labdvm/Phenix-1255-HW/documentation/images/FRDM-MCXN947.jpg

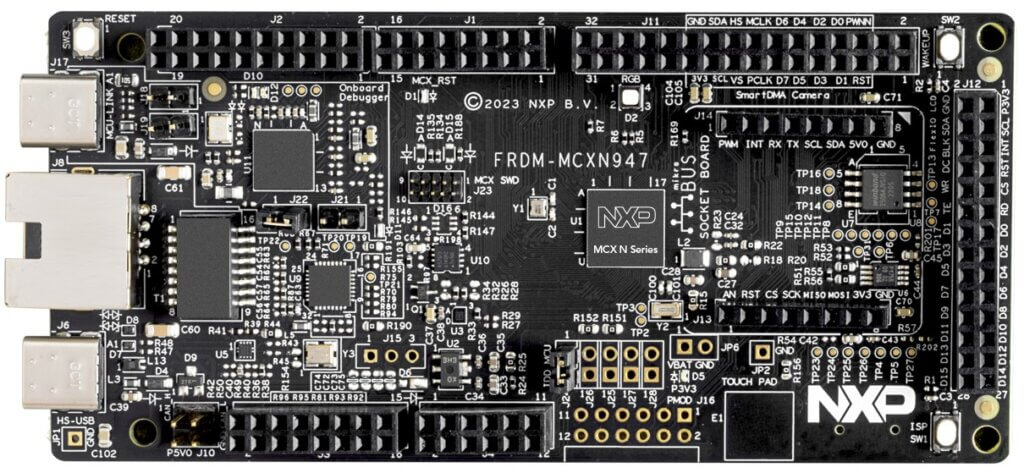
documentation/images/FRDM-MCXN947.jpg
