labdvm/Phenix-1255-HW/FRDM-SX1255+/FRDM-SX1255+ V2_b.png

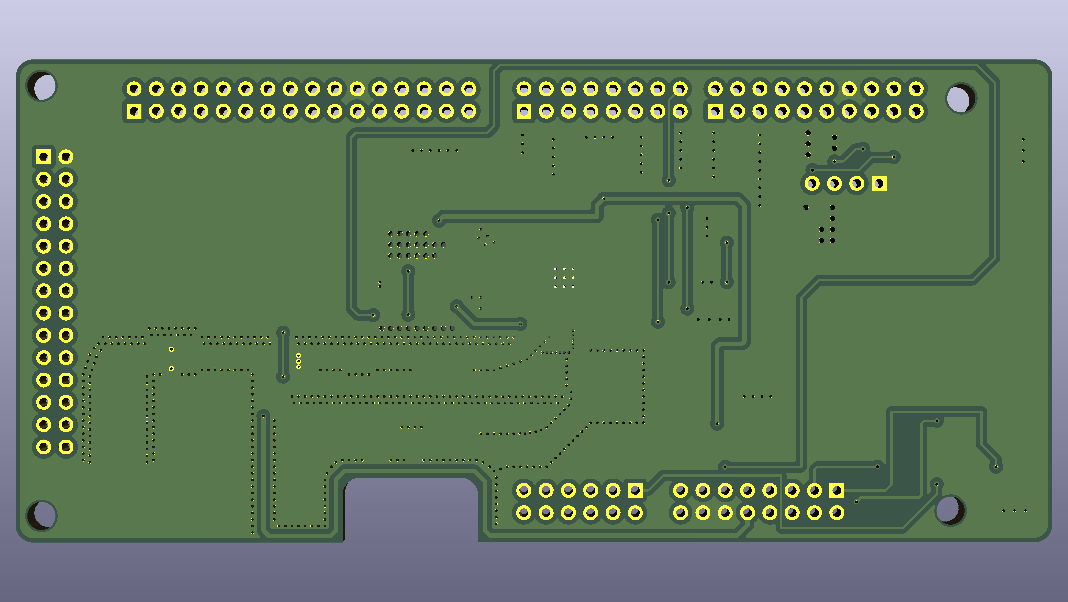
FRDM-SX1255+/FRDM-SX1255+ V2_b.png
