labdvm/Phenix-1255-HW/FRDM-SX1255/FRDM-SX1255-V2.png

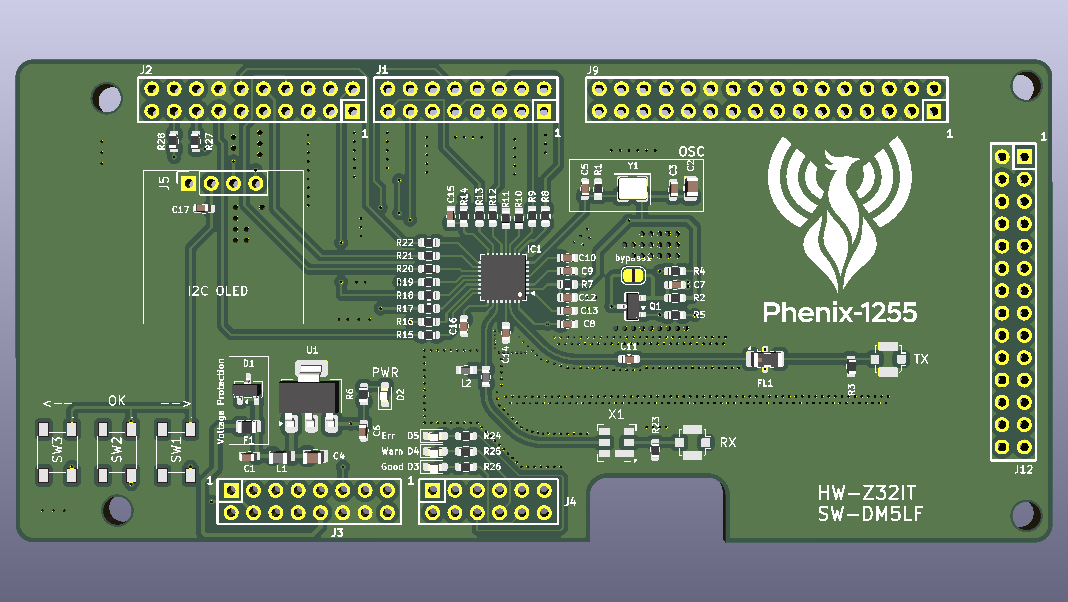
FRDM-SX1255/FRDM-SX1255-V2.png
