labdvm/Phenix-1255-HW/FRDM-SX1255+/Gerber and BOM/FRDM-SX1255+ V2.kicad_pcb_bom.csv

Designator | Quantity | Value | Footprint | Package | MPN | DNP | Mount_Type | KiLib_Generator | Manufacturer | Manufacturer Product Number | Description | DigiKey Part Number | Sim.Pin | TCXO-Footprints
C1, C12, C15, C18, C6, C7 | 6 | 1u | C_0603_1608Metric |  | 311-3484-1-ND |  | smt | SMD_2terminal_chip_molded | YAGEO | CC0603JRX7R6BB105
C10, C16, C17, C3, C8, C9 | 6 | 100n | C_0603_1608Metric |  | 720-1688-1-ND |  | smt | SMD_2terminal_chip_molded | Vishay Vitramon | VJ0603Y104JXQPW1BC
C11, C14, C19, C20 | 4 | 100p | C_0603_1608Metric |  | 399-15348-1-ND |  | smt | SMD_2terminal_chip_molded | KEMET | C0603C101J8GACTU
C13 | 1 | 10n | C_0603_1608Metric |  | 399-C0603C103K8RACTUCT-ND |  | smt | SMD_2terminal_chip_molded | KEMET | C0603C103K8RACTU
C2, C4 | 2 | 22u | C_0805_2012Metric |  | 1276-6526-1-ND |  | smt | SMD_2terminal_chip_molded | Samsung Electro-Mechanics | CL21A226KOQNNNE
C5 | 1 | 10p | C_0603_1608Metric |  | 399-14932-1-ND |  | smt | SMD_2terminal_chip_molded | KEMET | C0603C100J8GACTU
D1 | 1 | SP0502BAHT | SOT-23-3 |  |  |  | smt | package/gullwing | Littelfuse Inc. | SP0502BAHTG | TVS Diode Array, 5.5V Standoff, 2 Channels, SOT-23 package | F2714CT-ND
D2 | 1 | PWR | LED_0603_1608Metric_Pad1.05x0.95mm_HandSolder |  | 160-LTST-T180UWETCT-ND |  | smt | SMD_2terminal_chip_molded | Lite-On Inc. | LTST-T180UWET | Light emitting diode, small symbol |  | 1=K 2=A
D3 | 1 | Good | LED_0603_1608Metric_Pad1.05x0.95mm_HandSolder |  | 754-APT1608SGD3CT-ND |  | smt | SMD_2terminal_chip_molded | Kingbright | APT1608SGD3 | Light emitting diode, small symbol |  | 1=K 2=A
D4 | 1 | Warn | LED_0603_1608Metric_Pad1.05x0.95mm_HandSolder |  | 160-1437-1-ND |  | smt | SMD_2terminal_chip_molded | Lite-On Inc. | LTST-C190KSKT | Light emitting diode, small symbol |  | 1=K 2=A
D5 | 1 | Err | LED_0603_1608Metric_Pad1.05x0.95mm_HandSolder |  | 160-1479-1-ND |  | smt | SMD_2terminal_chip_molded | Lite-On Inc. | LTST-S270KRKT | Light emitting diode, small symbol |  | 1=K 2=A
F1 | 1 | 500mA | Fuse_0805_2012Metric |  |  |  | smt | SMD_2terminal_chip_molded | Littelfuse Inc. | 0805L050WR | Resettable fuse, polymeric positive temperature coefficient, small symbol | F2772CT-ND
FL1 | 1 | LFCN-490 | Filter_Mini-Circuits_FV1206 |  | 3157-LFCN-490+CT-ND |  | smt |  | Mini-Circuits | LFCN-490+
H1, H2, H3, H4 | 4 | Mechanical_MountingHole | MOUNTINGHOLE_3.2MM_M3 |  |  |  | tht
IC1 | 1 | SX1255 | QFN-32-1EP_5x5mm_P0.5mm_EP3.3x3.3mm_ThermalVias |  | SX1255IWLTRTCT-ND |  | smt | package/no_lead | Semtech Corporation | SX1255IWLTRT
J1 | 1 | TX | U.FL_Molex_MCRF_73412-0110_Vertical |  | 343-CONMHF1-SMD-G-TCT-ND |  | smt |  | TE Connectivity Linx | CONMHF1-SMD-G-T
J2 | 1 | RX | U.FL_Molex_MCRF_73412-0110_Vertical |  | 343-CONMHF1-SMD-G-TCT-ND |  | smt |  | TE Connectivity Linx | CONMHF1-SMD-G-T
L1 | 1 | 600 ohm/100MHz | L_0805_2012Metric |  | 490-1046-1-ND |  | smt | SMD_2terminal_chip_molded | Murata Electronics | BLM21BD601SN1D | FERRITE BEAD 600 OHM 0805 1LN
L2 | 1 | 82n | L_0603_1608Metric |  | 490-LQW18AS82NG00DCT-ND |  | smt | SMD_2terminal_chip_molded | Murata Electronics | LQW18AS82NG00D
L3 | 1 | 39n | L_0603_1608Metric |  | 490-LQW18AS39NG00DCT-ND |  | smt | SMD_2terminal_chip_molded | Murata Electronics | LQW18AS39NG00D
L4 | 1 | 68nH | L_0603_1608Metric |  | 490-1178-1-ND |  | smt | SMD_2terminal_chip_molded | Murata Electronics | LQW18AN68NJ00D
Q1 | 1 | BSS84 | SOT-23 |  | BSS84-TPMSCT-ND |  | smt | package/gullwing | MCC (Micro Commercial Components) | BSS84-TP
R1, R32, R4 | 3 | 10K | R_0603_1608Metric |  | 541-10.0KHCT-ND |  | smt | SMD_2terminal_chip_molded | Vishay Dale | CRCW060310K0FKEA
R10, R11, R12, R19, R20, R22, R5 | 7 | 330R | R_0603_1608Metric |  | 541-330HCT-ND |  | smt | SMD_2terminal_chip_molded | Vishay Dale | CRCW0603330RFKEA
R13, R15, R16, R17, R18, R21, R27, R28, R8, R9 | 10 | 33R | R_0603_1608Metric |  | 541-33.0HCT-ND |  | smt | SMD_2terminal_chip_molded | Vishay Dale | CRCW060333R0FKEA
R14, R2, R34, R7 | 4 | 1R | R_0603_1608Metric |  | 541-1.00HHCT-ND |  | smt | SMD_2terminal_chip_molded | Vishay Dale | CRCW06031R00FKEA
R23, R3 | 2 | 1M | R_0603_1608Metric |  | 541-1.00MHCT-ND |  | smt | SMD_2terminal_chip_molded | Vishay Dale | CRCW06031M00FKEA
R24, R25, R26 | 3 | 1K5 | R_0603_1608Metric |  | 541-1.5KGCT-ND |  | smt | SMD_2terminal_chip_molded | Vishay Dale | CRCW06031K50JNEA
R29, R31 | 2 | 150R | R_0603_1608Metric |  | YAG1533CT-ND |  | smt | SMD_2terminal_chip_molded | YAGEO | RT0603BRD07150RL
R30 | 1 | 36R | R_0603_1608Metric |  | 13-RT0603BRC0736RLCT-ND |  | smt | SMD_2terminal_chip_molded | YAGEO | RT0603BRC0736RL
R33 | 1 | 33K | R_0603_1608Metric |  | 541-33.0KHCT-ND |  | smt | SMD_2terminal_chip_molded | Vishay Dale | CRCW060333K0FKEA
R6 | 1 | 3K3 | R_0603_1608Metric |  | 541-3.30KHCT-ND |  | smt | SMD_2terminal_chip_molded | Vishay Dale | CRCW06033K30FKEA
SW1 | 1 | --> | PTS647SK38SMTR2LFS |  |  |  | smt |  | E-Switch | TL3305CF260QG | Push button switch, generic, two pins | EG5355CT-ND
SW2 | 1 | OK | PTS647SK38SMTR2LFS |  |  |  | smt |  | E-Switch | TL3305CF260QG | Push button switch, generic, two pins | EG5355CT-ND
SW3 | 1 | <-- | PTS647SK38SMTR2LFS |  |  |  | smt |  | E-Switch | TL3305CF260QG | Push button switch, generic, two pins | EG5355CT-ND
U1 | 1 | MCP1703Ax-330xxDB | SOT-223-3_TabPin2 |  | MCP1703T-3302E/DBCT-ND |  | smt |  | Microchip Technology | MCP1703T-3302E/DB
U2 | 1 | TQP3M9036 | SON50P200X200X95-9N |  | 2312-TQP3M9036CT-ND |  | smt |  | Qorvo | TQP3M9036
Y1 | 1 | 38.4MHz | Crystal_SMD_3225-4Pin_3.2x2.5mm |  | 114-TG2520SMN38.4000M-MCGNNM3CT-ND |  | smt | crystal_resonator_oscillator | EPSON | TG2520SMN 38.4000M-MCGNNM3 | Clipped SW/0.5~1ppm |  |  | 3225 or 2510
