labdvm/Phenix-1255-HW/FRDM-SX1255+/3dmodels/TA0655A.stp

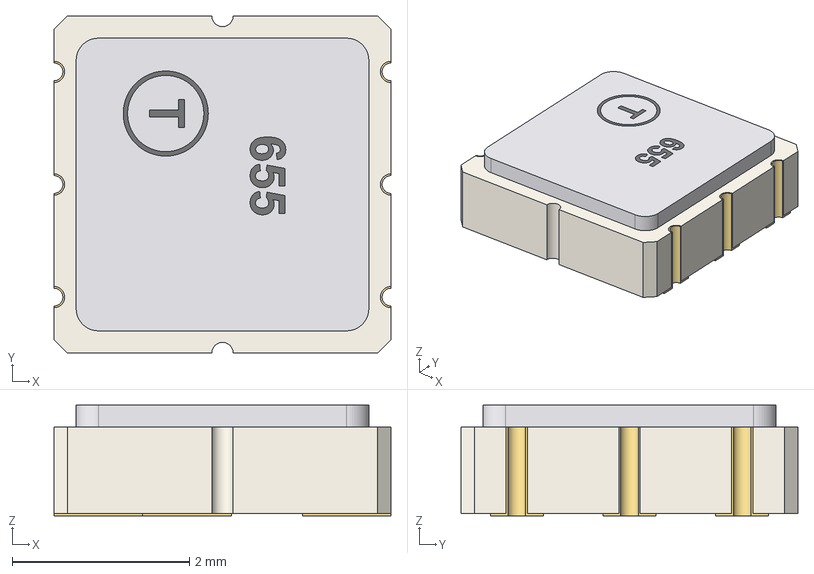
[picture p12: CAD file, 2026-11-04]
FRDM-SX1255+/3dmodels/TA0655A.stp
3.80 x 3.80 x 1.25 mm
lid
terminals
marking
