labdvm/Phenix-1255-HW/FRDM-SX1255/3dmodels/OLED_0.96in_128x64_I2C.stp

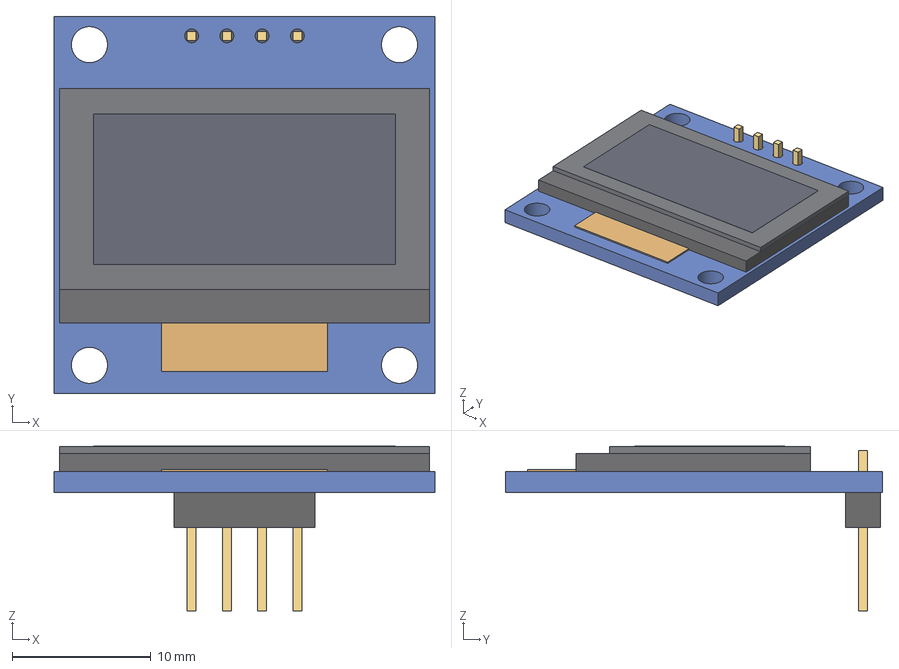
[picture p13: CAD file, 2026-11-04]
FRDM-SX1255/3dmodels/OLED_0.96in_128x64_I2C.stp
27.4 x 27.2 x 11.9 mm
pcb
glass
cover_glass
active_area
flex
header_body
header_pins
