labdvm/Phenix-1255-HW/FRDM-SX1255+/FRDM-SX1255+ V2.pdf

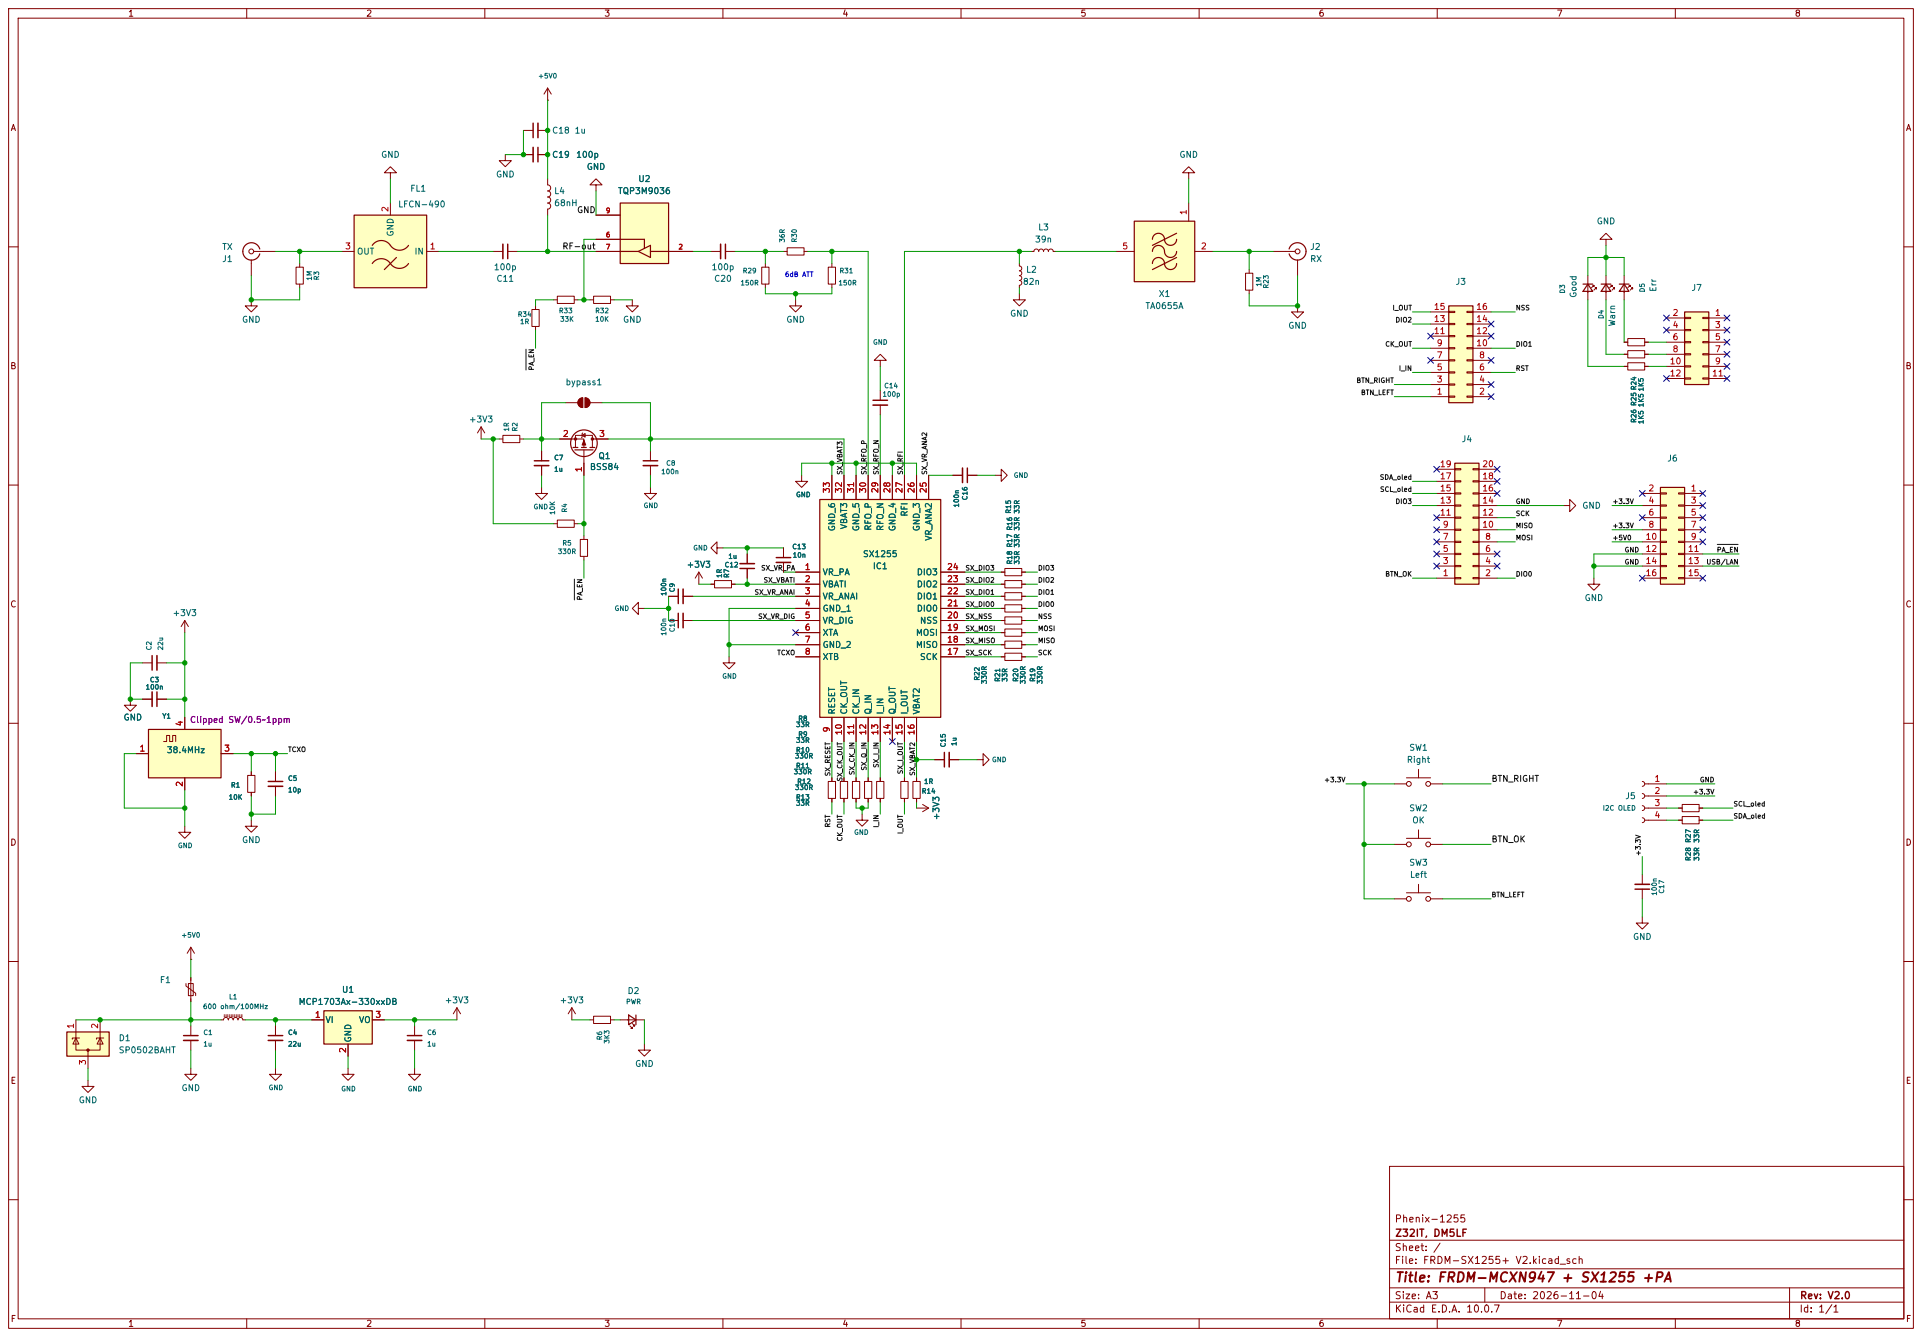
[picture p14: page 1]

Size: A3 | Rev: V2.0 | F Date: 2026-11-04
KiCad E.D.A. 10.0.7 | Id: 1/1
