labdvm/Phenix-1255-HW/FRDM-SX1255/FRDM-SX1255-V2.kicad_pcb

## KiCad design FRDM-SX1255/FRDM-SX1255-V2.kicad_pcb (2026-11-04)

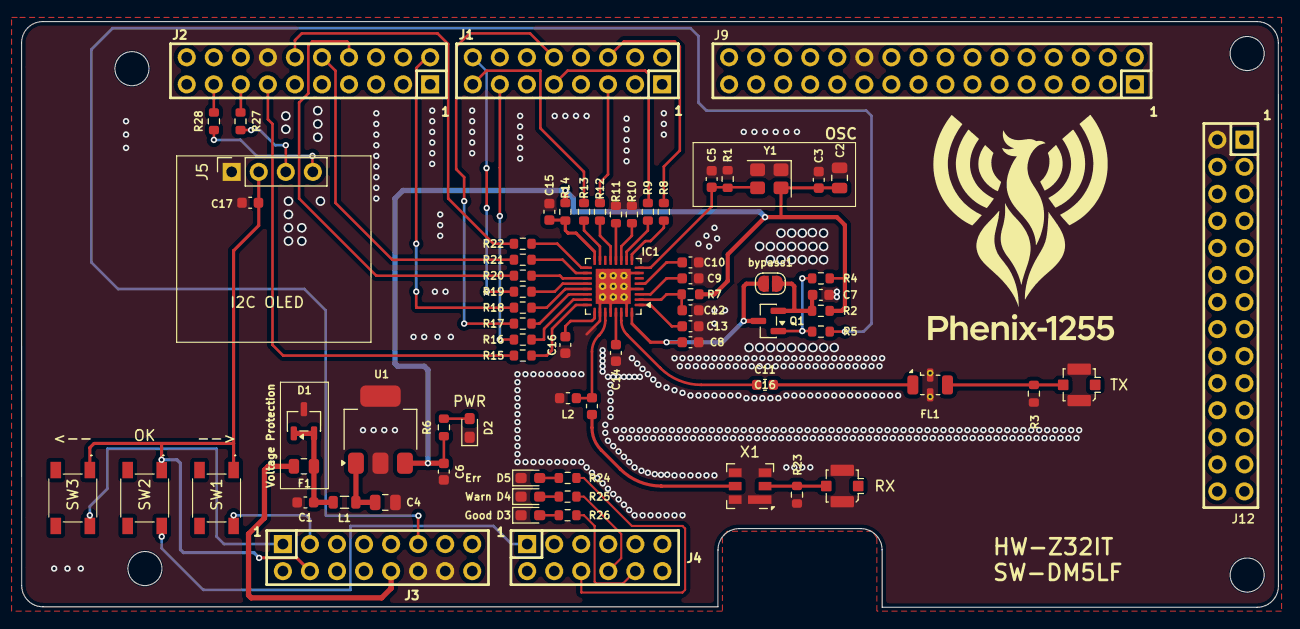
[picture p16: board FRDM-SX1255-V2.kicad_pcb from above]

Board: 2 copper layers, 118.0 x 55.0 mm, 77 parts (0 on the bottom side), 61 nets.

Parts:
C1, C6, C7, C12, C15: 1u; C_0603_1608Metric
C2, C4: 22u; C_0805_2012Metric
C3, C8, C9, C10, C16, C17: 100n; C_0603_1608Metric
C5: 10p; C_0603_1608Metric
C11, C14: 100p; C_0603_1608Metric
C13: 10n; C_0603_1608Metric
D1: SP0502BAHT; SOT-23-3
D2: PWR; LED_0603_1608Metric_Pad1.05x0.95mm_HandSolder
D3: Good; LED_0603_1608Metric_Pad1.05x0.95mm_HandSolder
D4: Warn; LED_0603_1608Metric_Pad1.05x0.95mm_HandSolder
D5: Err; LED_0603_1608Metric_Pad1.05x0.95mm_HandSolder
F1: 500mA; Fuse_0805_2012Metric
FL1: LFCN-490; Filter_Mini-Circuits_FV1206
H1, H2, H3, H4: Mechanical_MountingHole; MOUNTINGHOLE_3.2MM_M3
IC1: SX1255; QFN-32-1EP_5x5mm_P0.5mm_EP3.3x3.3mm_ThermalVias
J1, J3: SSQ-108-03-T-D
J1#2: TX; U.FL_Molex_MCRF_73412-0110_Vertical
J2: RX; U.FL_Molex_MCRF_73412-0110_Vertical
J2#2: SSQ-110-03-T-D
J4: SSQ-106-03-T-D
J5: I2C OLED; PinSocket_1x04_P2.54mm_Vertical
J9: SSQ-116-03-T-D
J12: SSQ-114-03-T-D
L1: 600 ohm/100MHz; L_0805_2012Metric
L2: 82n; L_0603_1608Metric
L3: 39n; L_0603_1608Metric
Q1: BSS84; SOT-23
R1, R4: 10K; R_0603_1608Metric
R2, R7, R14: 1R; R_0603_1608Metric
R3, R23: 1M; R_0603_1608Metric
R5, R10, R11, R12, R19, R20, R22: 330R; R_0603_1608Metric
R6: 3K3; R_0603_1608Metric
R8, R9, R13, R15, R16, R17, R18, R21, R27, R28: 33R; R_0603_1608Metric
R24, R25, R26: 1K5; R_0603_1608Metric
SW1: -->; PTS647SK38SMTR2LFS
SW2: OK; PTS647SK38SMTR2LFS
SW3: <--; PTS647SK38SMTR2LFS
U1: MCP1703Ax-330xxDB; SOT-223-3_TabPin2
X1: TA0655A; Filter_SAW-6_3.8x3.8mm
Y1: 38.4MHz; Crystal_SMD_3225-4Pin_3.2x2.5mm
bypass1: Bypass; SolderJumper-2_P1.3mm_Open_RoundedPad1.0x1.5mm

Connections:
+3V3: C2.2, C3.1, C6.1, R2.2, R4.2, R6.2, R7.2, R14.1, U1.3 (VO), Y1.4 (VDD)
+5V0: F1.1, J3.10
/+3.3V: C17.2, J3.4, J5.2, SW1.1, SW2.1, SW3.1
/BTN_LEFT: J3.1, SW3.2
/BTN_OK: J4.1, SW2.2
/BTN_RIGHT: J3.3, SW1.2
/CK_OUT: J1.9, R9.1
/DIO0: J2#2.2, R18.1
/DIO1: J1.10, R17.1
/DIO2: J1.13, R16.1
/DIO3: J2#2.13, R15.1
/I_IN: J1.5, R12.1
/I_OUT: J1.15, R13.1
/MISO: J2#2.10, R21.1
/MOSI: J2#2.8, R20.1
/NSS: J1.16, R19.1
/RST: J1.6, R8.1
/SCK: J2#2.12, R22.1
/SCL_oled: J2#2.15, R27.2
/SDA_oled: J2#2.17, R28.2
/SX_CK_IN: IC1.11 (CK_IN), R10.2
/SX_CK_OUT: IC1.10 (CK_OUT), R9.2
/SX_DIO0: IC1.21 (DIO0), R18.2
/SX_DIO1: IC1.22 (DIO1), R17.2
/SX_DIO2: IC1.23 (DIO2), R16.2
/SX_DIO3: IC1.24 (DIO3), R15.2
/SX_I_IN: IC1.13 (I_IN), R12.2
/SX_I_OUT: IC1.15 (I_OUT), R13.2
/SX_MISO: IC1.18 (MISO), R21.2
/SX_MOSI: IC1.19 (MOSI), R20.2
/SX_NSS: IC1.20 (NSS), R19.2
/SX_Q_IN: IC1.12 (Q_IN), R11.2
/SX_RESET: IC1.9 (RESET), R8.2
/SX_RFI: IC1.27 (RFI), L2.2, L3.2
/SX_RFO_N: C14.2, IC1.29 (RFO_N)
/SX_RFO_P: C11.1, IC1.30 (RFO_P)
/SX_SCK: IC1.17 (SCK), R22.2
/SX_VBAT2: C15.1, IC1.16 (VBAT2), R14.2
/SX_VBAT3: C8.1, IC1.32 (VBAT3), Q1.3 (D), bypass1.2 (B)
/SX_VBATI: C12.1, IC1.2 (VBATI), R7.1
/SX_VR_ANA2: C16.2, IC1.25 (VR_ANA2)
/SX_VR_ANAI: C9.2, IC1.3 (VR_ANAI)
/SX_VR_DIG: C10.2, IC1.5 (VR_DIG)
/SX_VR_PA: C13.2, IC1.1 (VR_PA)
/TCXO: C5.1, IC1.8 (XTB), R1.1, Y1.3 (OUT)
/~PA_EN: J3.11, R5.1
GND: C1.2, C2.1, C3.2, C4.2, C5.2, C6.2, C7.2, C8.2, C9.1, C10.1, C12.2, C13.1, C14.1, C15.2, C16.1, C17.1, D1.3 (A), D2.1 (K), D3.1 (K), D4.1 (K), D5.1 (K), FL1.2 (GND), FL1.4 (GND), IC1.4 (GND_1), IC1.7 (GND_2), IC1.26 (GND_3), IC1.28 (GND_4), IC1.31 (GND_5), IC1.33 (GND_6), J1#2.2 (Ext), J2.2 (Ext), J2#2.14, J3.12, J3.14, J5.1, J9.22, J12.2, L2.1, R1.2, R3.1, R10.1, R11.1, R23.1, U1.2 (GND), X1.1 (GND), X1.3 (GND), X1.4 (GND), X1.6 (GND), Y1.1 (Tri-State), Y1.2 (GND)
unnamed: C1.1, D1.1 (K), D1.2 (K), F1.2, L1.1
unnamed: D2.2 (A), R6.1
unnamed: D3.2 (A), R26.2
unnamed: D4.2 (A), R25.2
unnamed: D5.2 (A), R24.2
unnamed: C11.2, FL1.1 (IN)
unnamed: FL1.3 (OUT), J1#2.1 (In), R3.2
unnamed: J2.1 (In), R23.2, X1.2 (IN)
unnamed: J5.3, R27.1
unnamed: J5.4, R28.1
unnamed: Q1.1 (G), R4.1, R5.2
unnamed: C7.1, Q1.2 (S), R2.1, bypass1.1 (A)
unnamed: C4.1, L1.2, U1.1 (VI)
unnamed: L3.1, X1.5 (OUT)
