labdvm/Phenix-1255-HW/(commit log)

2026-10-28 Add software link to README
    Added software link for the board in README.
2026-10-29 Add files via upload
    This is with PA onboard.
    [FRDM-SX1255+.kicad_pcb, FRDM-SX1255+.kicad_pcb_bom.csv, FRDM-SX1255+.kicad_pcb_positions.csv, FRDM-SX1255+.kicad_sch]
2026-11-02 Revise RX filter details in README
    Updated RX filter information in README.
2026-11-04 Update documentation and 3D models
    [FRDM-SX1255+ V2.kicad_pcb, FRDM-SX1255-V2.kicad_pcb, FRDM-SX1255-V2.kicad_pcb_bom.csv, FRDM-SX1255-V2.kicad_pcb_positions.csv, FRDM-SX1255-V2.kicad_sch, OLED_0.96in_128x64_I2C.stp, TA0655A.stp]
