labdvm/Phenix-1255-HW/(notices)

Notices in the files:
README.md:
License: CERN-OHL-P v2
